SakshamKamath/MuP-Design-Assignment/MuP Design Assignment/MuP Design Project/MuP Design Project/ON-PAPER DESIGN.pptx

## ON-PAPER DESIGN Group-7 Batch Weighing Machine MuP - 2020-21

## Slide 2

- In some places, Vcc and GND are not available on the chip. They have been shown separately near the chip
- All the Vcc’s mentioned in the on paper design are 5V unless labelled explicitly giving a different voltage

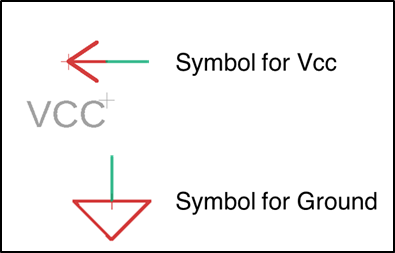
[picture p6: figure]

## Slide 3

8284 - Clock Generator

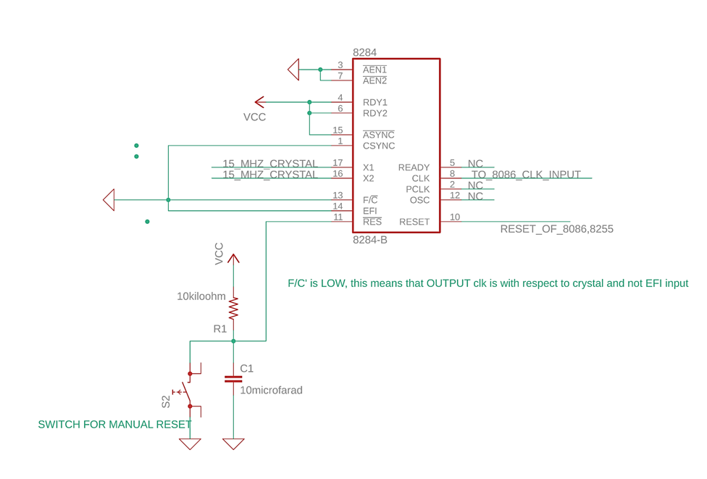
[picture p7: figure]
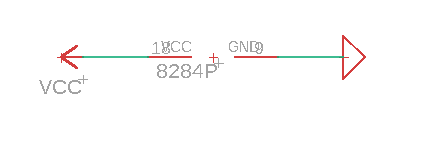
[picture p8: figure]

## Slide 4

8086

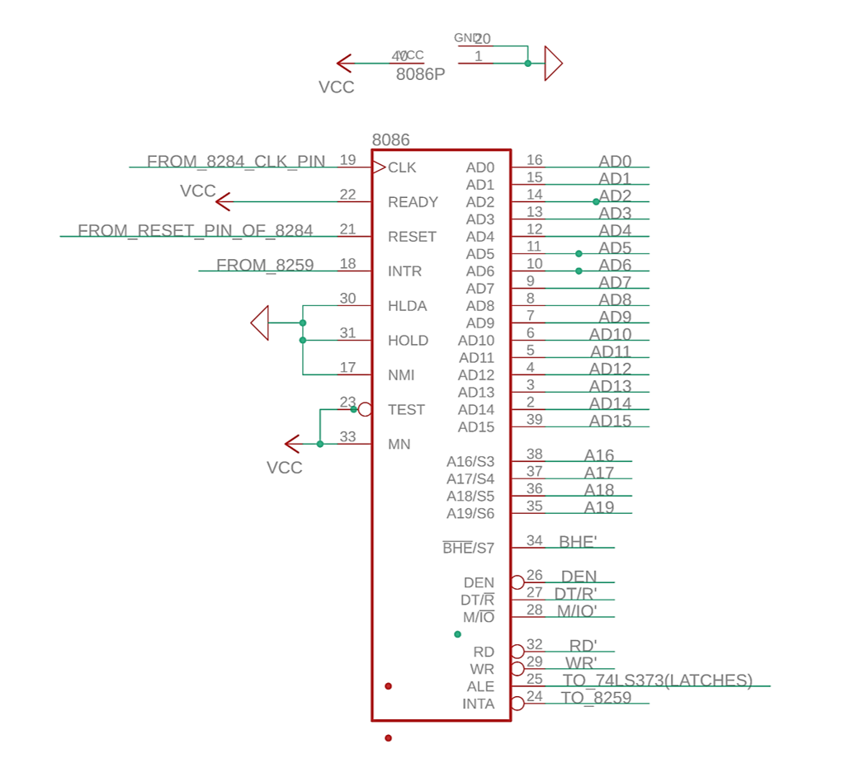
[picture p9: figure]

## Slide 5

74LS373 Latch

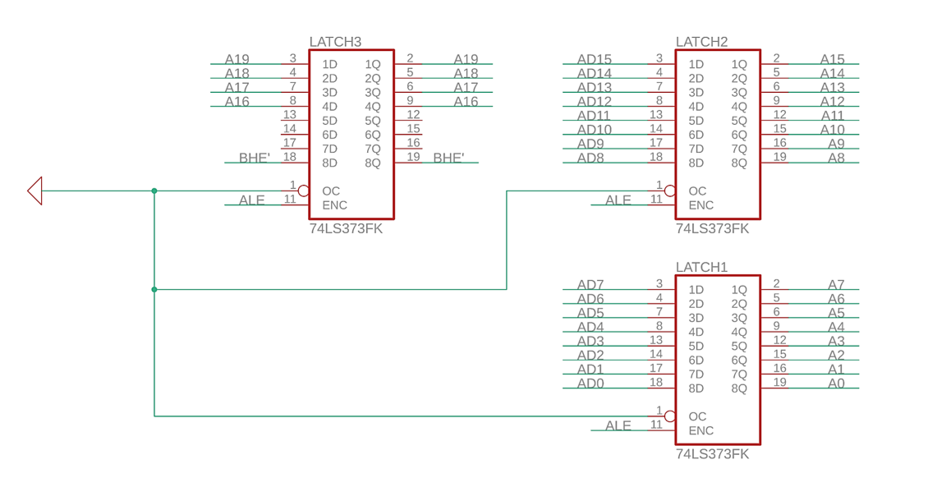
[picture p10: figure]
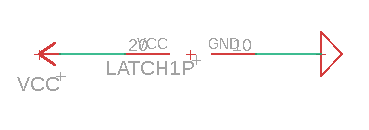
[picture p11: figure]

## Slide 6

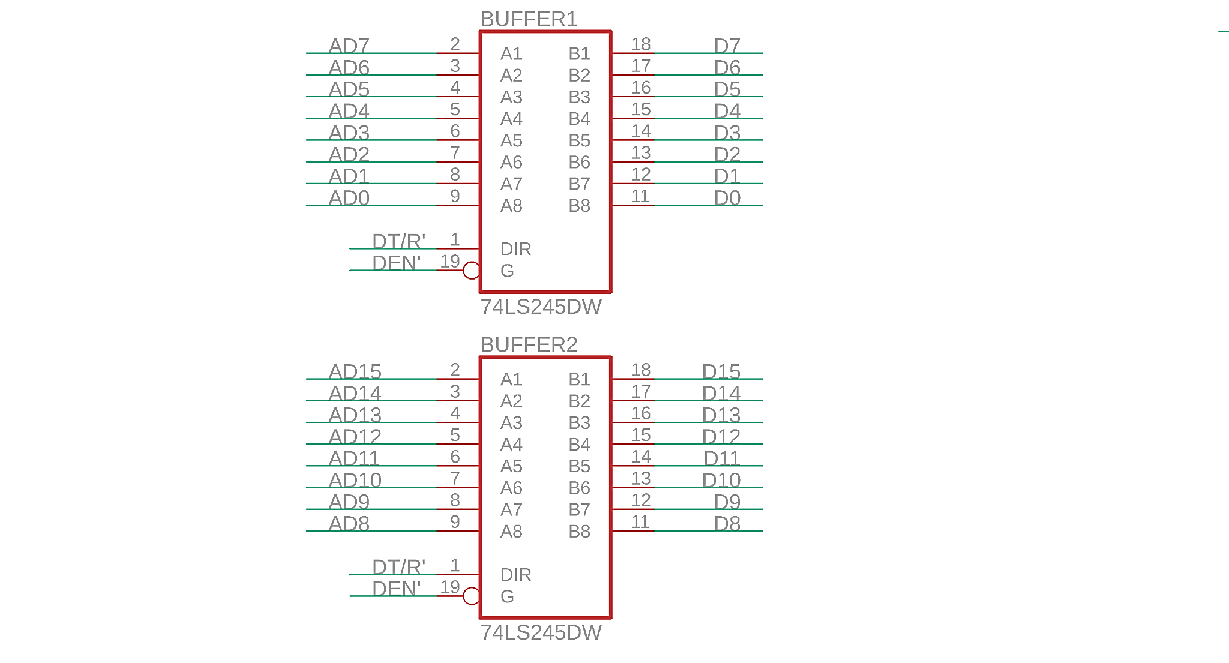
[picture p12: figure]

Data Bus Buffers

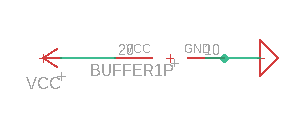
[picture p13: figure]

## Slide 7

Control
Signals

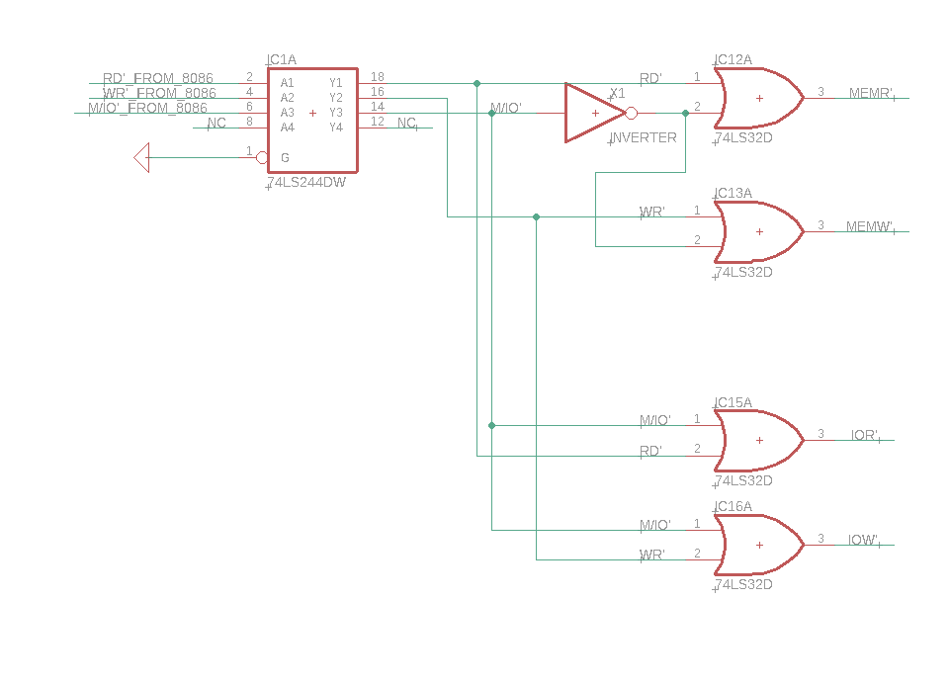
[picture p14: figure]

Buffer

Control Signals

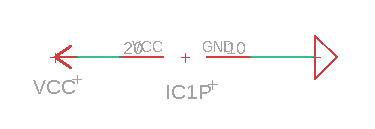
[picture p15: figure]

## Slide 8

Logic for the formation of control signals

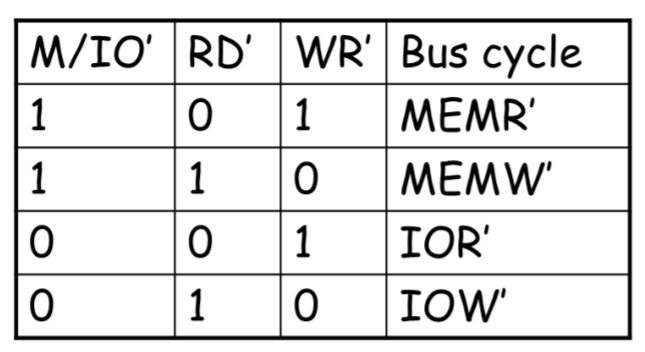
[picture p16: figure]

## Slide 9

RAM_FROM MEMORY DECODER

Chip Select for even, odd banks

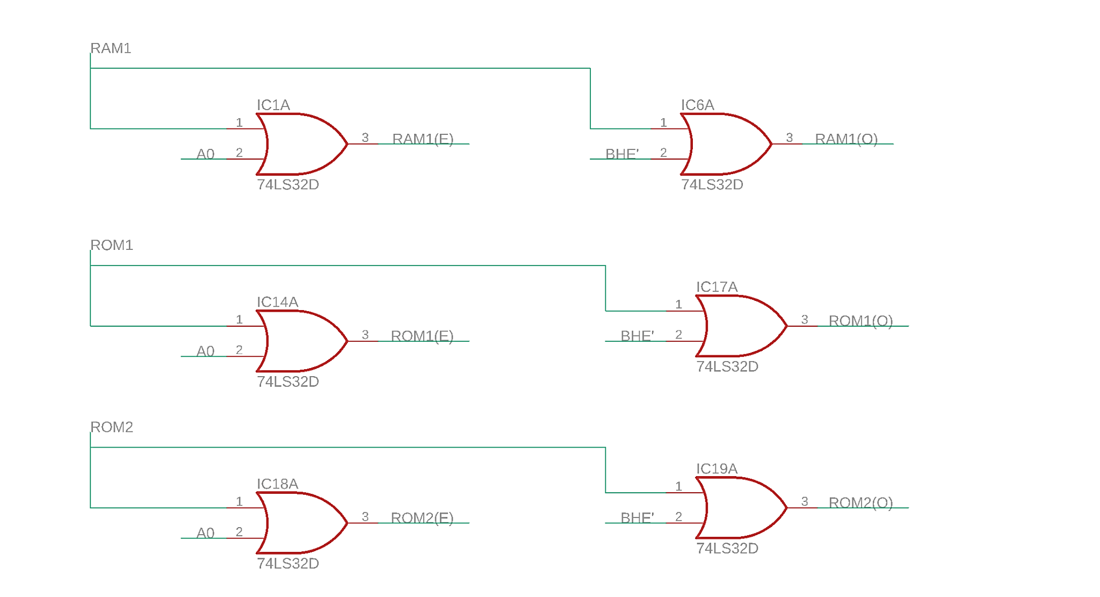
[picture p17: figure]

ROM_1_FROM MEMORY DECODER

ROM_2_FROM MEMORY DECODER

## Slide 10

74LS138 - Memory Decoder

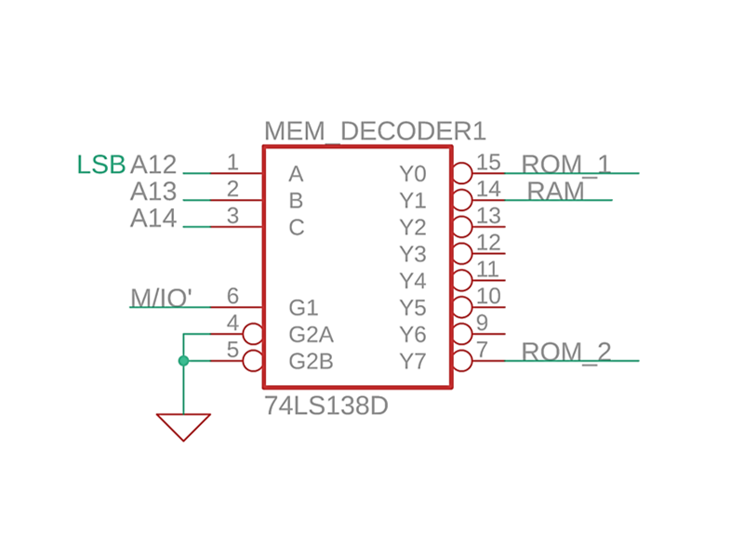
[picture p18: figure]

## Slide 11

6116-
2K RAM

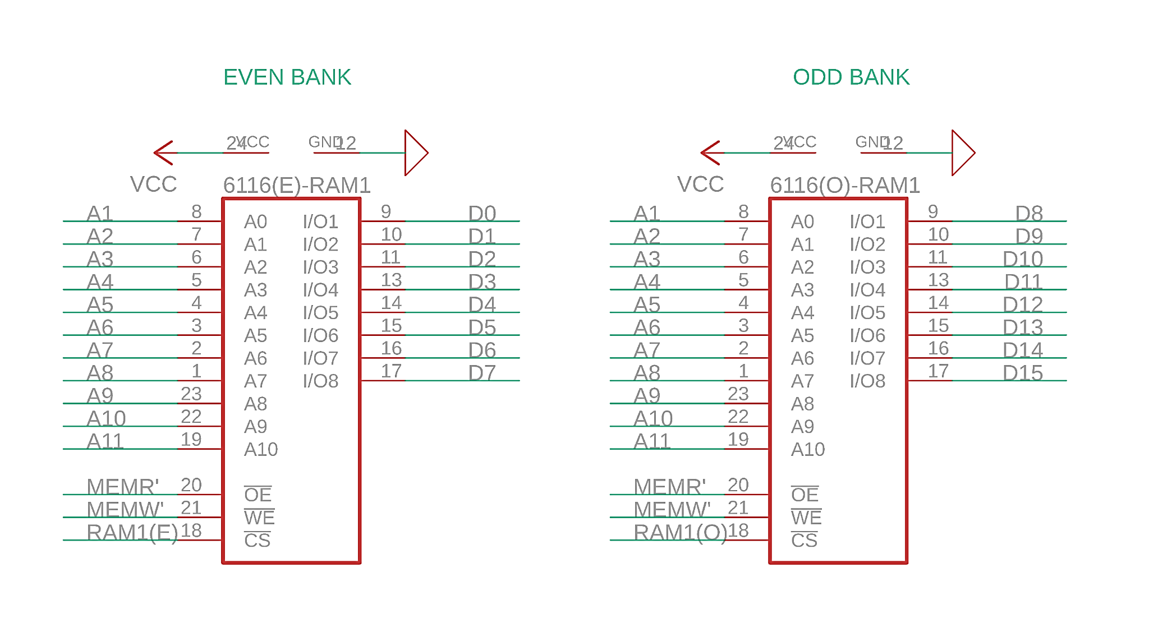
[picture p19: figure]

## Slide 12

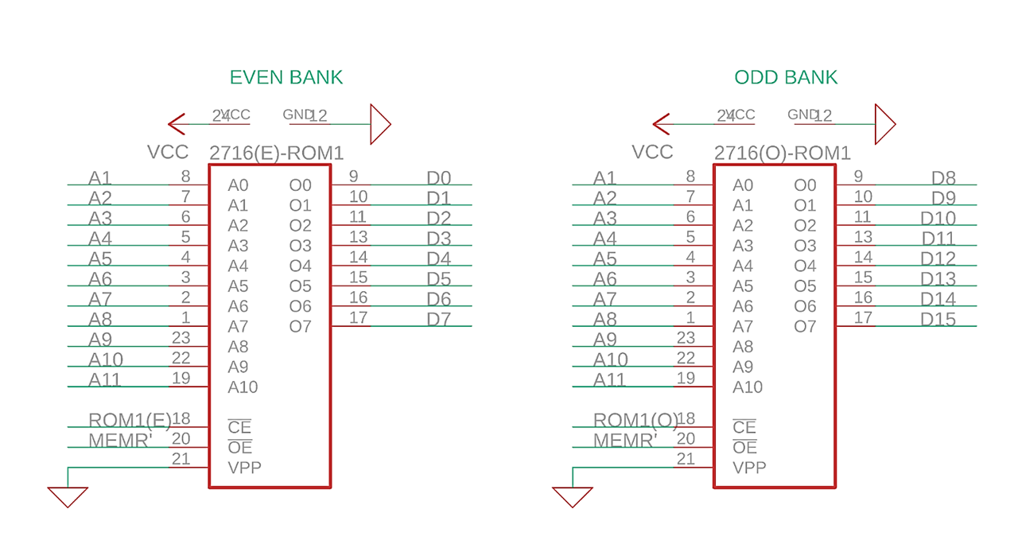
[picture p20: figure]

2716-
2K ROM1

## Slide 13

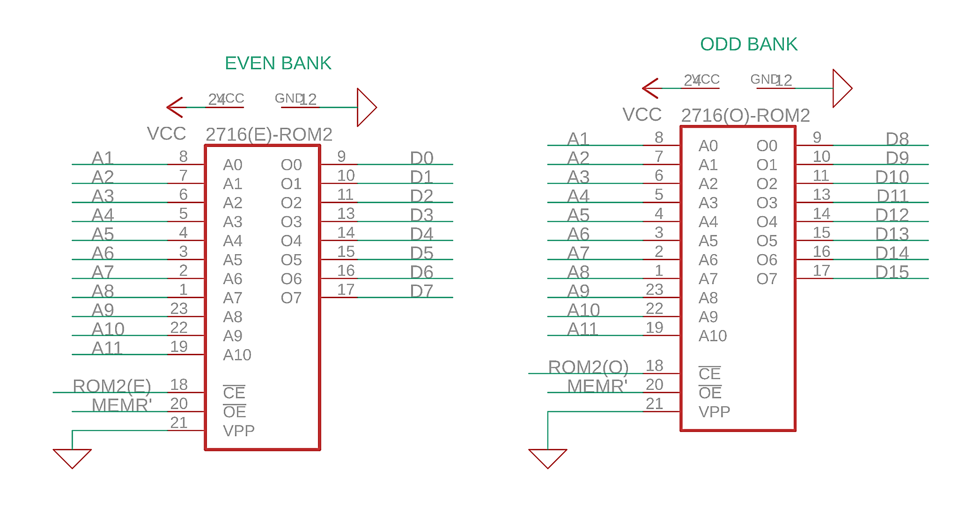
[picture p21: figure]

2716-
2K ROM2

## Slide 14

74LS138 - IO Decoder

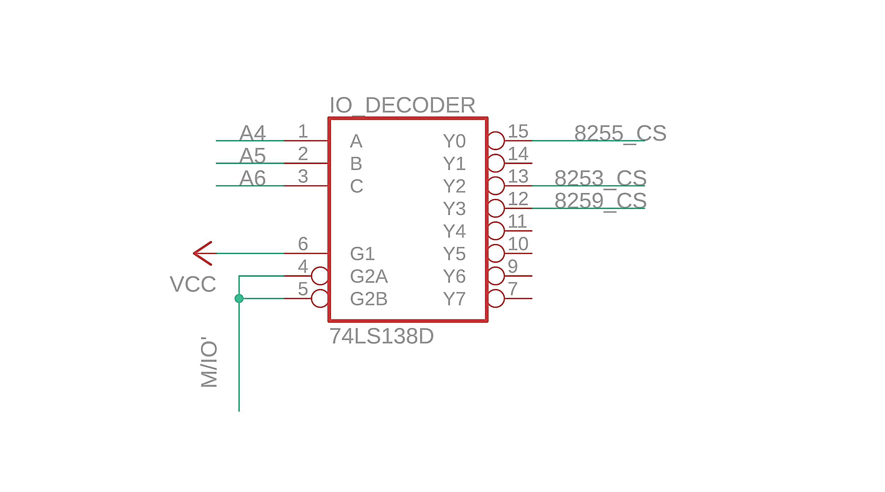
[picture p22: figure]

## Slide 15

8254 - Programmable Interval Timer

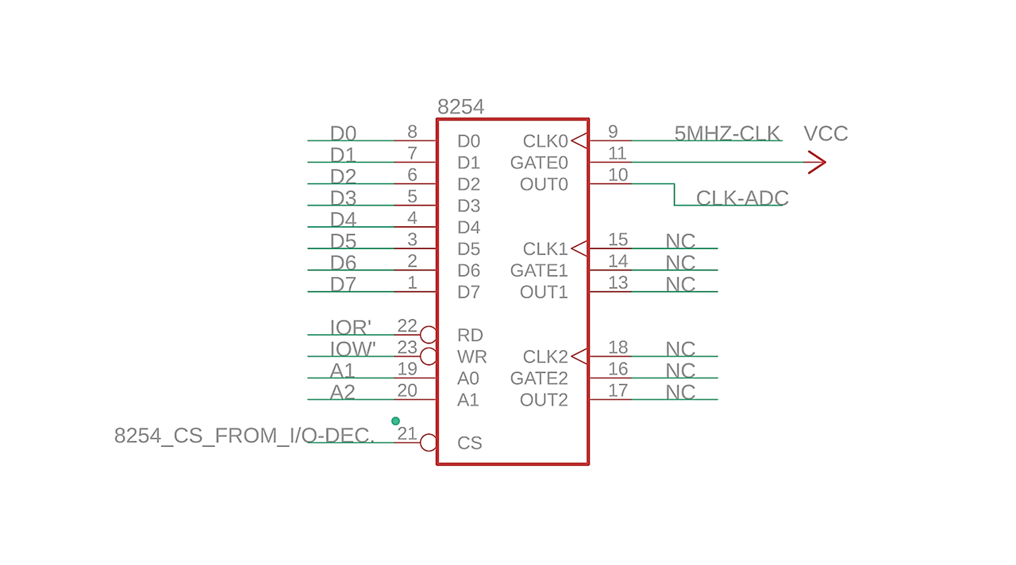
[picture p23: figure]

## Slide 16

8255 - Programmable Peripheral Interface

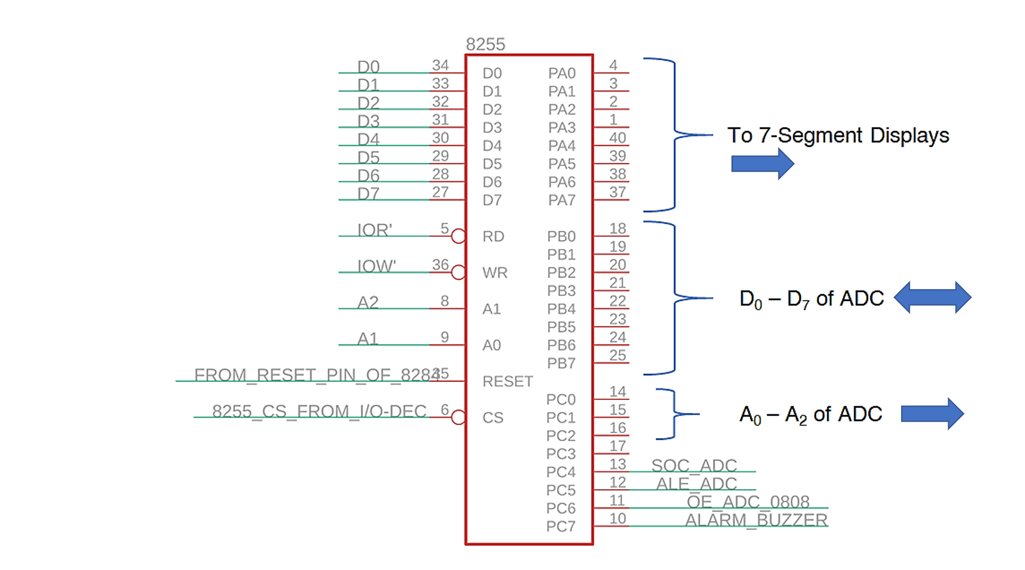
[picture p24: figure]
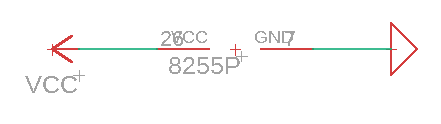
[picture p25: figure]

## Slide 17

Relay for Alarm

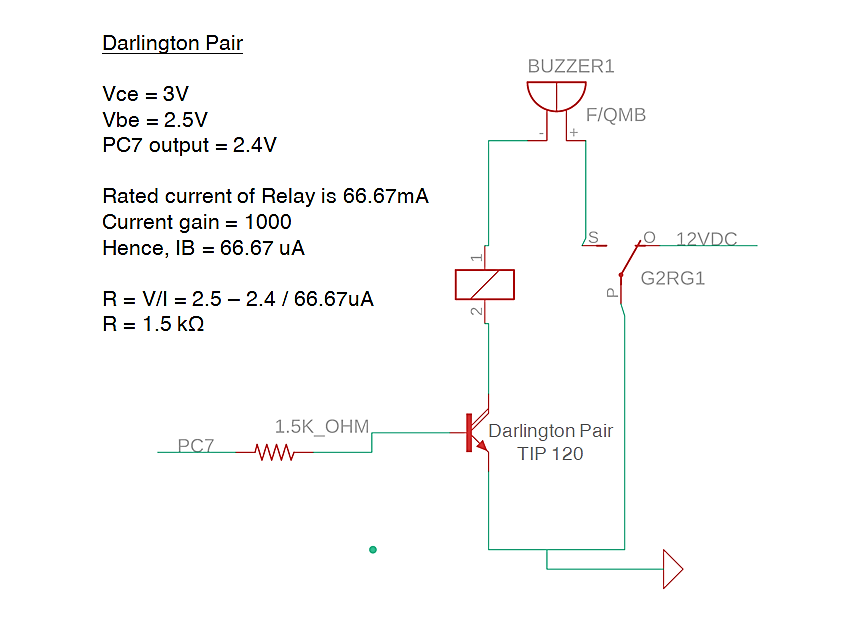
[picture p26: figure]

## Slide 18

74LS47N &
7-segment displays (common anode)

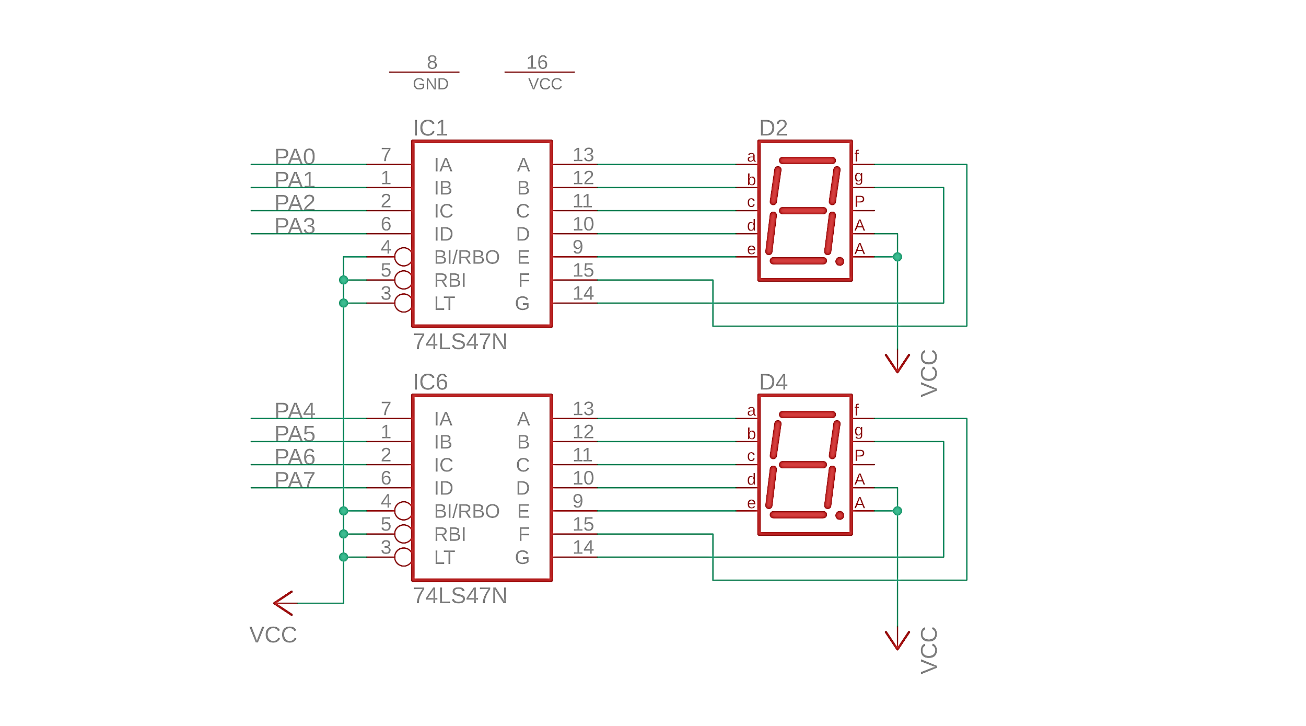
[picture p27: figure]

IC1G$2

Units Place

10s Place

## Slide 19

ADC 0808 - Analog-Digital Convertor

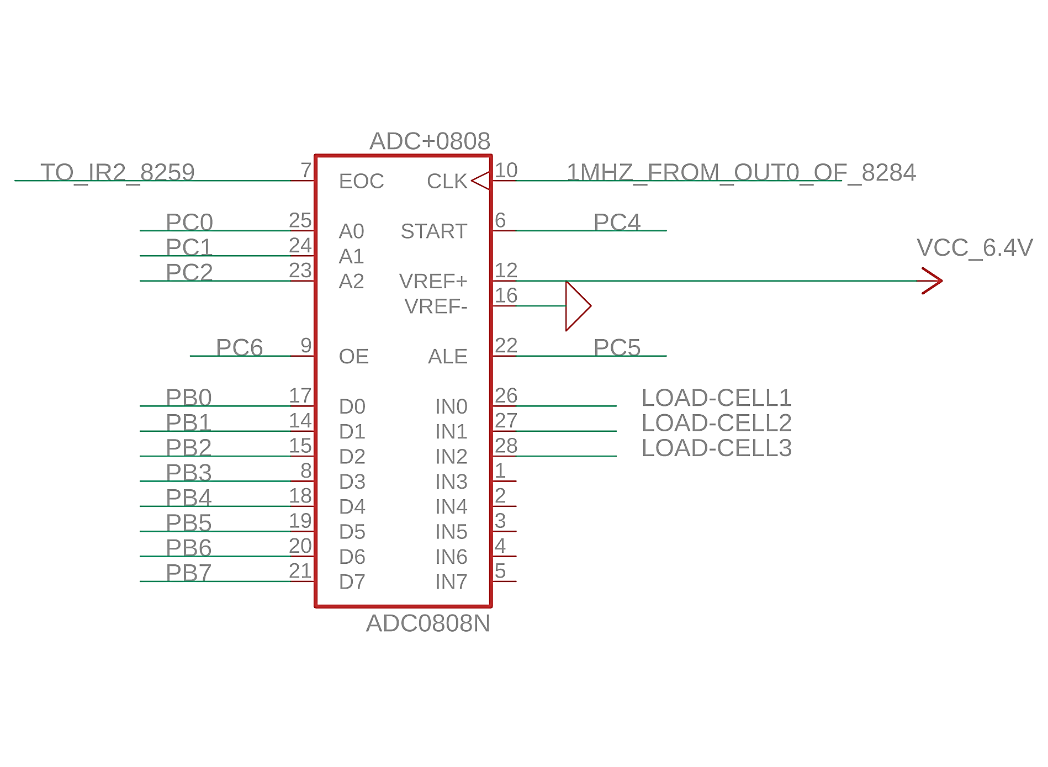
[picture p28: figure]

Vout (given in Problem Statement)
for Load Cell = 0.025 x weight(kg)
Therefore resolution is 0.025V
(25mV)
Now,
X / 256 = 0.025
X = 6.4 V
Where X is Vref+ to be found out
Since we are using 8-bit ADC, 2^8(256)
mappings are possible

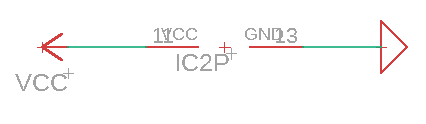
[picture p29: figure]

## Slide 20

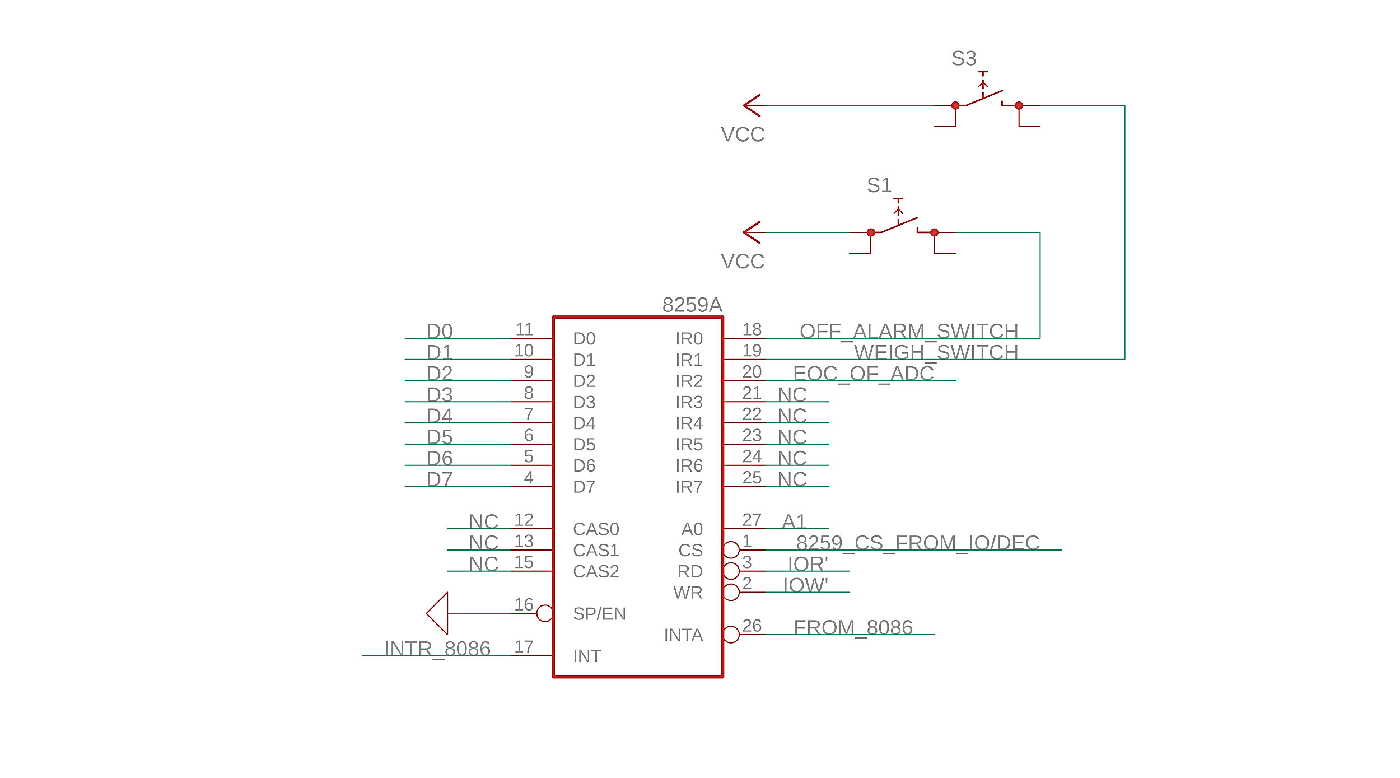
[picture p30: figure]

8259 - Interrupt Controller

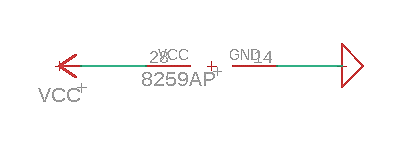
[picture p31: figure]

INTA’

## END OF FILE
