SakshamKamath/MuP-Design-Assignment/MuP Design Assignment/MuP Design Project/MuP Design Project/On-Paper Images Data/8086-2.png

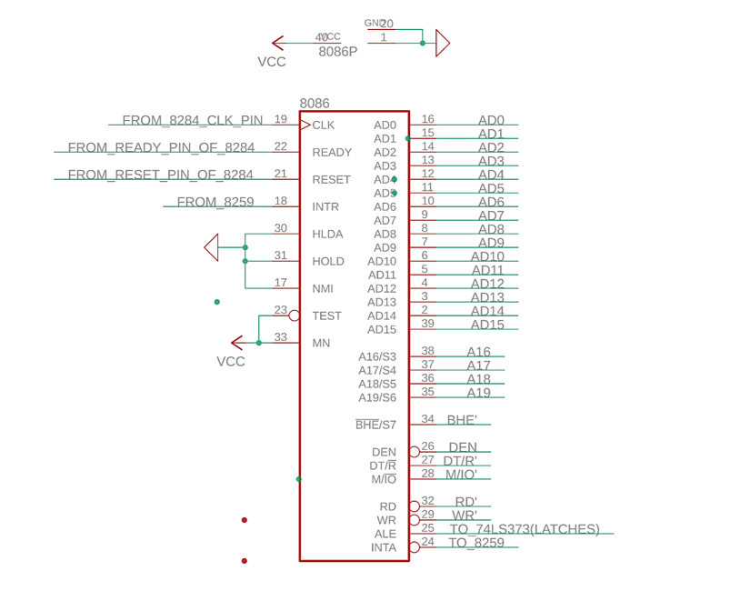
MuP Design Assignment/MuP Design Project/MuP Design Project/On-Paper Images Data/8086-2.png
