SakshamKamath/MuP-Design-Assignment/MuP Design Assignment/MuP Design Project/MuP Design Project/On-Paper Images Data/8284.png

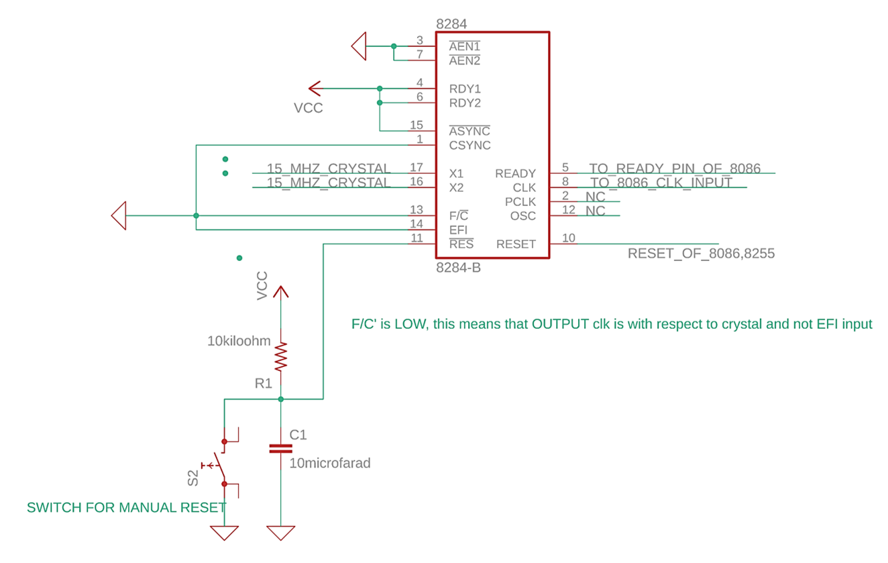
MuP Design Assignment/MuP Design Project/MuP Design Project/On-Paper Images Data/8284.png
