SakshamKamath/MuP-Design-Assignment/MuP Design Assignment/MuP Design Project/MuP Design Project/On-Paper Images Data/ADC 0808.png

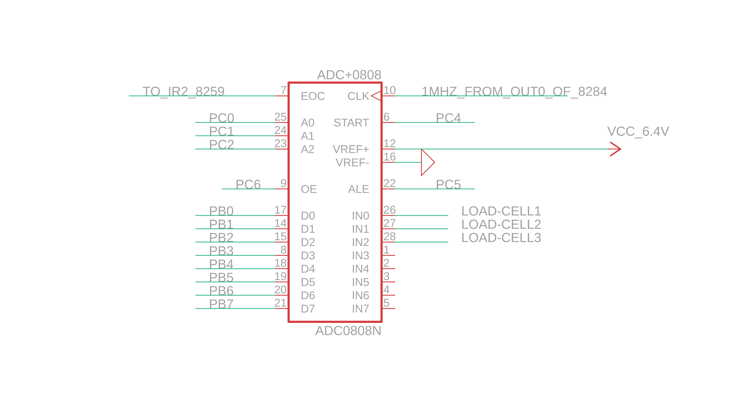
MuP Design Assignment/MuP Design Project/MuP Design Project/On-Paper Images Data/ADC 0808.png
