SakshamKamath/MuP-Design-Assignment/(list of files, drawings)

Other design files:
MuP Design Assignment/MuP Design Project/MuP Design Project/G7_final/Proteus Design.DSN
MuP Design Assignment/MuP Design Project/MuP Design Project/Proteus Design/According to On Paper.DSN
MuP Design Assignment/MuP Design Project/MuP Design Project/Proteus Design/DSN/G60(1).DSN
MuP Design Assignment/MuP Design Project/MuP Design Project/Proteus Design/DSN/G60(2).DSN
MuP Design Assignment/MuP Design Project/MuP Design Project/Proteus Design/DSN/G60.DSN
MuP Design Assignment/MuP Design Project/MuP Design Project/Proteus Design/G60 Before Control Signals.DSN
MuP Design Assignment/MuP Design Project/MuP Design Project/Proteus Design/G60.DSN
